AndesRobot-Oficial/Structure-Embedded-Systems/cad/README.md

# Modelo CAD

Archivo CAD del robot: modelo 3D completo de MILO, hecho en **Autodesk Fusion 360**.

| Archivo | Descripción |
|---|---|
| [`milo_ensamblaje.step`](milo_ensamblaje.step) | Ensamblaje completo en STEP (17 MB), exportado de Fusion 360 el 25-10-2026. Se abre en cualquier CAD |
| _por subir_ | Archivo nativo de Fusion (`.f3z`) |

## Cómo exportar desde Fusion 360

- **`.f3z`:** Archivo → Exportar → *Fusion Archive Files (.f3z)*. Incluye todas las piezas referenciadas del ensamblaje.
- **`.step`:** Archivo → Exportar → *STEP Files (.step)*.

Al actualizar el modelo, reemplaza los dos archivos y anota el cambio en el [CHANGELOG](../CHANGELOG.md).

> GitHub acepta archivos de hasta 100 MB.
