AndesRobot-Oficial/Structure-Embedded-Systems/electrica/README.md

# Eléctrica

Diagrama de conexiones de MILO.

| Contenido | Descripción |
|---|---|
| [`esquematicos/`](esquematicos/README.md) | Plano eléctrico (mapa de conexiones de ReWire) y árbol de potencia |
| [`cableado/`](cableado/README.md) | Lista de los 137 cables por circuito |
| [`presupuesto_potencia.csv`](presupuesto_potencia.csv) | Consumo de cada componente |
| [`revision_plano.md`](revision_plano.md) | Revisión del plano: puntos pendientes |
