AndesRobot-Oficial/Structure-Embedded-Systems/bom/README.md

# Lista de materiales (BOM)

Lista de componentes de MILO: todo lo que hay que comprar o fabricar.

## Componentes eléctricos

### Energía

| Componente | Modelo / N° de parte | Cant. | Notas |
|---|---|:-:|---|
| Batería Li-ion 10S2P 36 V · 4,4 Ah · 158 Wh | BMS 20 A continuos / 30 A pico | 2 | Carga a 42 V |
| Conversor DC-DC 42 V → 24 V, 20 A | UENPO (entrada 30–75 V) | 1 | |
| Conversor DC-DC 24 V → 12 V, 20 A | Kuongshun (entrada 6–40 V) | 1 | 15 A continuos |
| Conversor DC-DC 24 V → 6,6 V, 300 W | Kuongshun (entrada 7–32 V) | 1 | Hasta 8 A |

### Seguridad

| Componente | Modelo / N° de parte | Cant. | Notas |
|---|---|:-:|---|
| Seta de emergencia | 2 contactos NC | 1 | |

### Tracción

| Componente | Modelo / N° de parte | Cant. | Notas |
|---|---|:-:|---|
| Placa controladora de hoverboard | STM32, firmware FOC (EFeru) | 1 | |
| Pulsador de encendido | Original de la placa | 1 | |
| Rueda con motor BLDC en buje 6,5" | 36 V · ~350 W | 2 | |

### Control

| Componente | Modelo / N° de parte | Cant. | Notas |
|---|---|:-:|---|
| Computador principal | NVIDIA Jetson Orin Nano Dev Kit | 1 | Entrada 9–20 V |
| Microcontrolador | Arduino Mega 2560 | 1 | |
| Adaptador USB a TTL | CH340G | 1 | Puente 5 V / 3,3 V |
| Hub USB 3.0 alimentado, 7 puertos | Entrada 12 V | 1 | |

### Sensores

| Componente | Modelo / N° de parte | Cant. | Notas |
|---|---|:-:|---|
| Cámara de profundidad | Orbbec Gemini Plus | 1 | |
| LiDAR | Slamtec RPLIDAR C1 | 1 | |
| IMU 9 ejes USB | Handsfree HFI-B9 | 1 | |
| IMU 9 ejes I2C | MPU-9250 (módulo GY-9250) | 1 | |
| Cámara de visión IA | Hiwonder WonderMV (K210) | 1 | |

### Pantallas

| Componente | Modelo / N° de parte | Cant. | Notas |
|---|---|:-:|---|
| Monitor 11,6" | MUCAI N116A | 1 | Modelo no definitivo |
| Pantalla táctil 5" | Victron GX Touch 50 | 1 | Modelo no definitivo |
| Hub DisplayPort MST (1× DP → 2× HDMI) | _por elegir_ | 1 | |

### Actuadores

| Componente | Modelo / N° de parte | Cant. | Notas |
|---|---|:-:|---|
| Driver paso a paso (9–42 V · 0,5–4,0 A) | TB6600 | 7 | |
| Motor NEMA 23, 1,26 N·m · 2,8 A/fase | StepperOnline 23HS22-2804S1 | 3 | |
| Motor NEMA 23, 2,9 N·m · 3,0 A/fase | 57HS112-3004 | 1 | |
| Motor NEMA 17, ~0,45 N·m · ~1,5 A/fase | _por confirmar_ | 3 | Confirmar corriente en la etiqueta |
| Servo digital 20 kg·cm a 6,6 V | Power HD LF-20MG | 1 | |

## Perfilería

| Componente | Medida | Cant. | Notas |
|---|---|:-:|---|
| | | | |

## Tornillería

| Componente | Medida | Cant. | Notas |
|---|---|:-:|---|
| | | | |
