AndesRobot-Oficial/Structure-Embedded-Systems/electrica/presupuesto_potencia.csv

componente | cantidad | riel | voltaje_v | potencia_tipica_w_c_u | potencia_max_w_c_u | fuente_dato | notas
Placa hoverboard + ruedas BLDC 6.5" | 1 | 36 V batería | 36 | 50 | 612 | estimado | Típica = avance en piso plano interior (estimado). Máx = límite de corriente del firmware FOC por defecto (~17 A DC); confirmar con la configuración real
Jetson Orin Nano Dev Kit | 1 | 12 V | 12 | 15 | 25 | datasheet NVIDIA (modos 7-25 W) | Depende del modo de potencia (nvpmodel)
Hub USB 3.0 alimentado (propio) | 1 | 12 V | 12 | 1 | 2 | estimado | Sin contar lo que entrega por los puertos
Monitor MUCAI N116A | 1 | 5 V USB (hub) | 5 |  |  | confirmar | Ver si el puerto del hub alcanza a entregarle la corriente
Victron GX Touch 50 | 1 | 5 V USB (hub) | 5 |  |  | confirmar
Hub DisplayPort MST | 1 | 5 V USB (hub) | 5 |  |  | confirmar | Modelo por elegir
Orbbec Gemini Plus | 1 | 5 V USB (Jetson) | 5 |  |  | confirmar
RPLIDAR C1 | 1 | 5 V USB (hub) | 5 |  |  | confirmar
IMU HFI-B9 | 1 | 5 V USB (hub) | 5 |  |  | confirmar
Hiwonder WonderMV | 1 | 5 V USB (hub) | 5 | 1.5 | 1.5 | plano (5 V ~300 mA)
USB a TTL CH340G | 1 | 5 V USB (hub) | 5 | 0.1 | 0.1 | estimado
Arduino Mega 2560 + MPU-9250 | 1 | 5 V USB (Jetson) | 5 | 0.5 | 1 | estimado
TB6600 + NEMA 23 23HS22-2804S1 (1.26 N·m) | 3 | 24 V | 24 | 14 | 14 | estimado (2 fases × 2.8 A² × 0.89 Ω) | Pérdida en el motor con corriente nominal; se reduce si el driver baja la corriente en reposo
TB6600 + NEMA 23 57HS112-3004 (2.9 N·m) | 1 | 24 V | 24 | 23 | 23 | estimado (2 fases × 3.0 A² × 1.3 Ω) | Ídem
TB6600 + NEMA 17 | 3 | 24 V | 24 | 9 | 9 | estimado (~1.5 A/fase; confirmar etiqueta) | Ídem
Servo Power HD LF-20MG | 1 | 6.6 V | 6.6 |  |  | confirmar | Usar corriente de bloqueo del datasheet como máx
