AndesRobot-Oficial/Structure-Embedded-Systems/cad/milo_ensamblaje.step

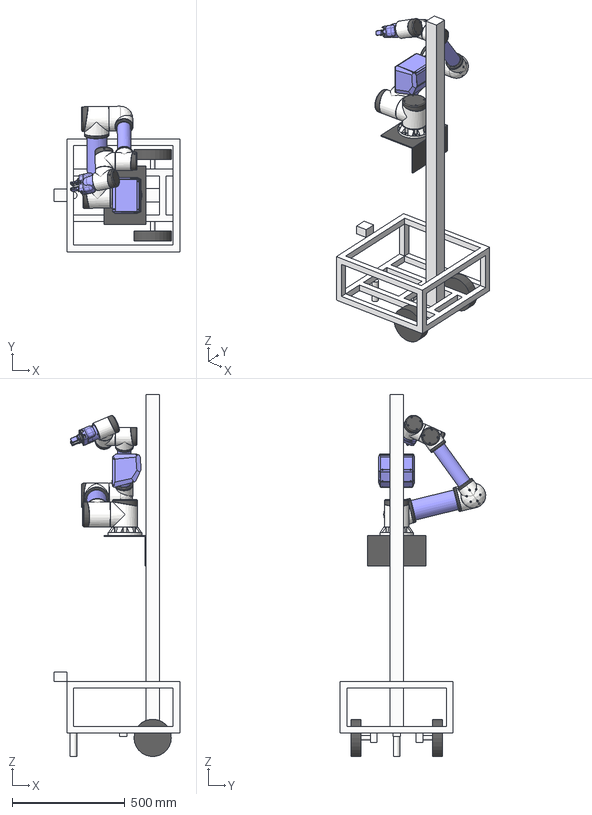
[picture p1: CAD file, 2026-10-26]
cad/milo_ensamblaje.step
555.8 x 644.6 x 1603.0 mm
old_component (1)
old_component (2)
old_component (3)
old_component (4)
old_component (6)
old_component (7)
old_component (8)
old_component (9)
old_component (10)
old_component (11)
old_component (12)
old_component
old_component (13)
old_component (14)
old_component (15)
old_component (16)
old_component (17)
Venus_Touch - display-screen_MODEL_1
Victron_CCGX2_Screen
RealSense_D435
