AndesRobot-Oficial/Structure-Embedded-Systems/milo_description/meshes/link_1_1.stl

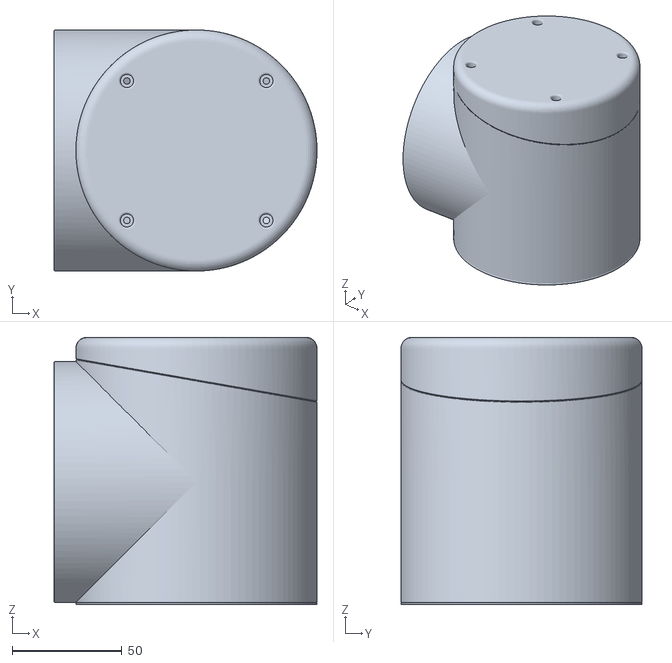
[picture p2: CAD file, 2026-10-26]
milo_description/meshes/link_1_1.stl
120.0 x 110.0 x 122.0
