AndesRobot-Oficial/Structure-Embedded-Systems/milo_description/meshes/link_6_1.stl

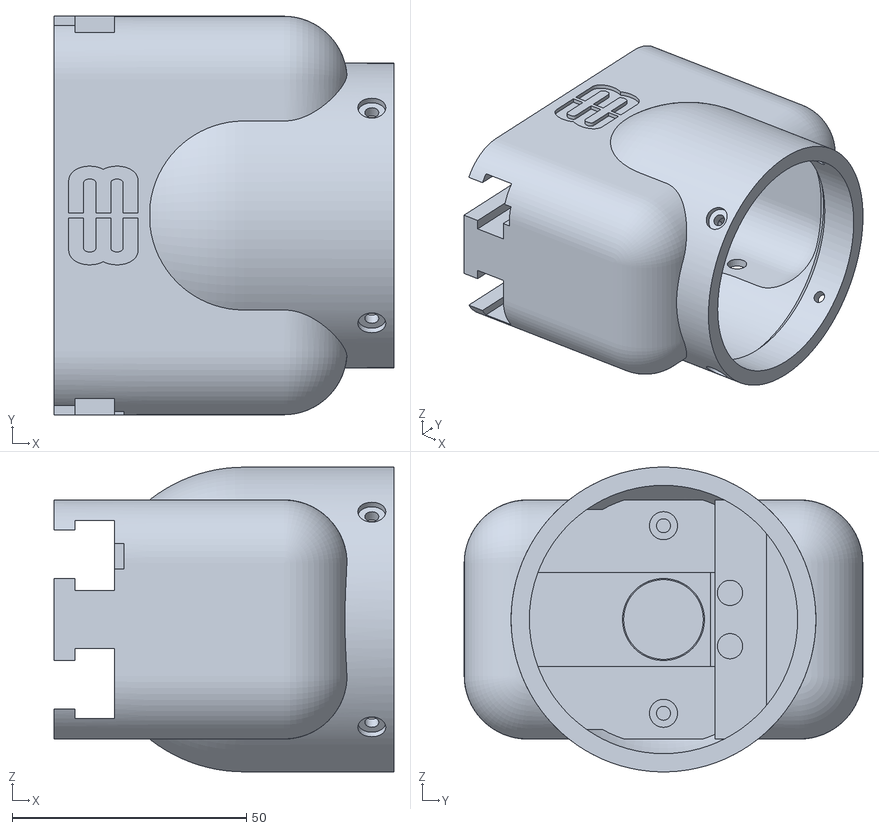
[picture p3: CAD file, 2026-10-26]
milo_description/meshes/link_6_1.stl
72.5 x 85.0 x 65.0
