AndesRobot-Oficial/Structure-Embedded-Systems/milo_description/meshes/link_3_1.stl

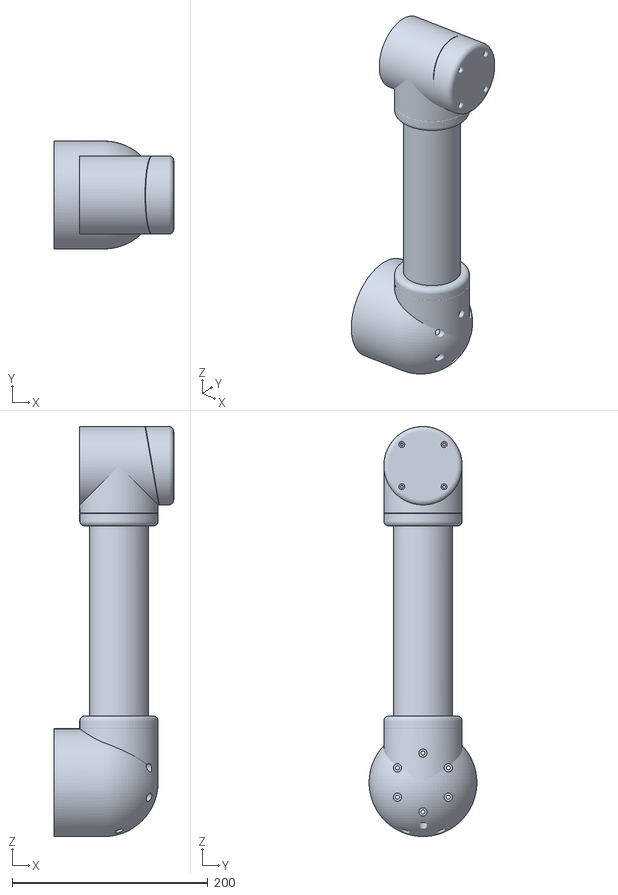
[picture p4: CAD file, 2026-10-26]
milo_description/meshes/link_3_1.stl
122.0 x 110.0 x 418.5
