AndesRobot-Oficial/Structure-Embedded-Systems/milo_description/meshes/imu_link_1.stl

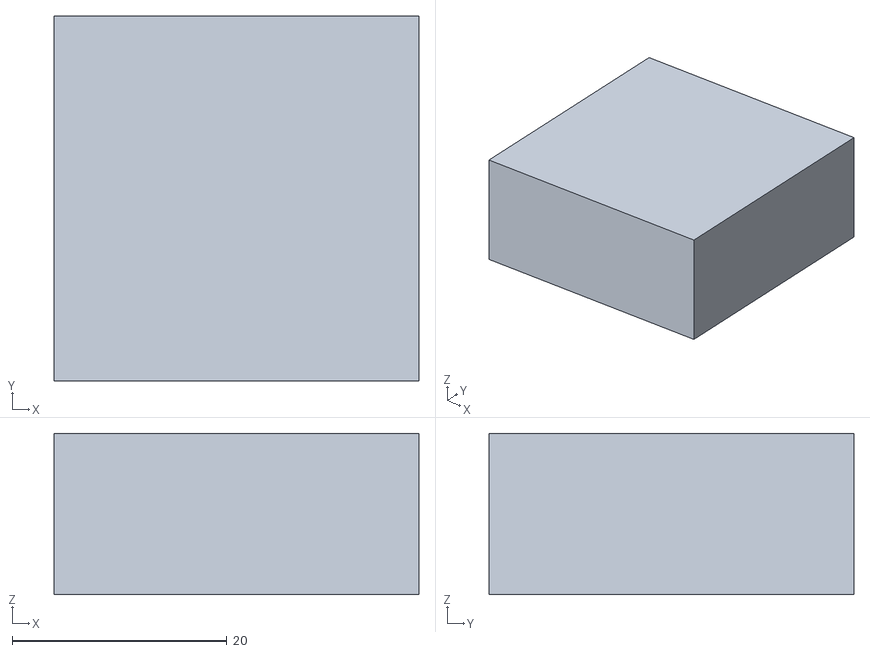
[picture p5: CAD file, 2026-10-26]
milo_description/meshes/imu_link_1.stl
34.0 x 34.0 x 15.0
