AndesRobot-Oficial/Structure-Embedded-Systems/milo_description/meshes/right_wheel_link_1.stl

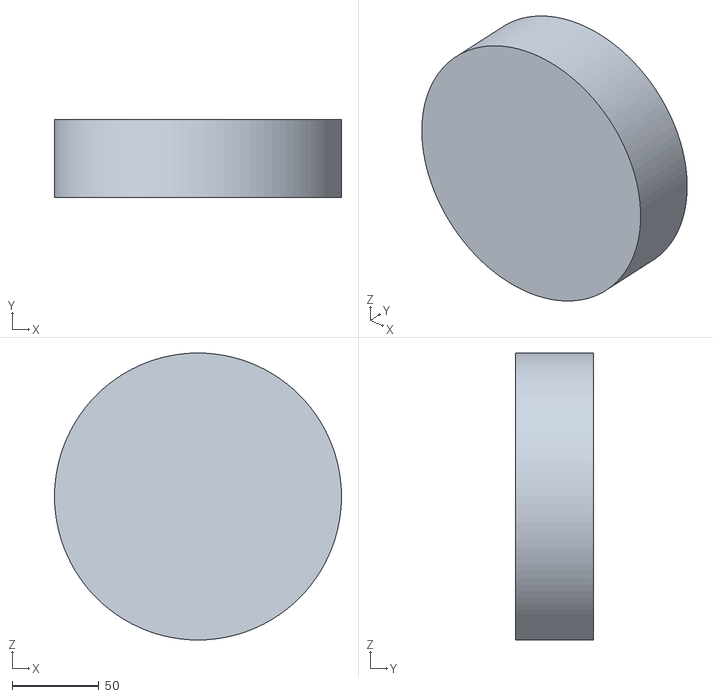
[picture p6: CAD file, 2026-10-26]
milo_description/meshes/right_wheel_link_1.stl
165.1 x 45.0 x 165.1
