AndesRobot-Oficial/Structure-Embedded-Systems/milo_description/meshes/vertical_column_link_1.stl

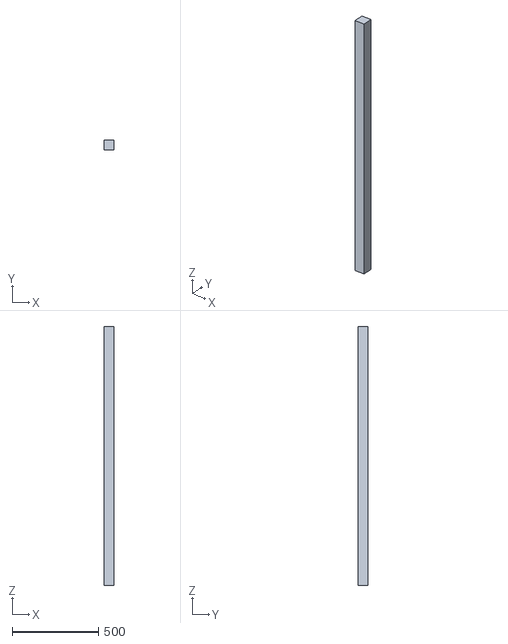
[picture p7: CAD file, 2026-10-26]
milo_description/meshes/vertical_column_link_1.stl
60.0 x 60.0 x 1500.0
