AndesRobot-Oficial/Structure-Embedded-Systems/milo_description/meshes/left_finger_link_1.stl

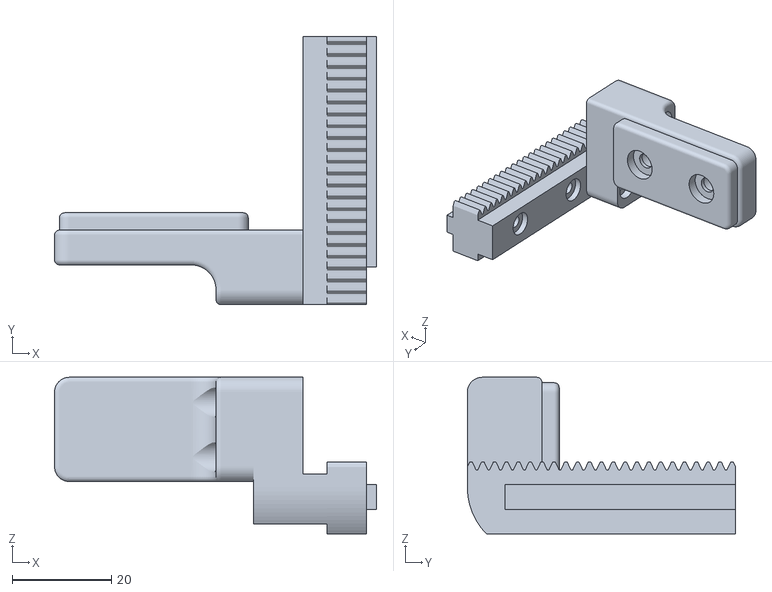
[picture p8: CAD file, 2026-10-26]
milo_description/meshes/left_finger_link_1.stl
64.8 x 54.0 x 31.5
