AndesRobot-Oficial/Structure-Embedded-Systems/milo_description/meshes/link_2_1.stl

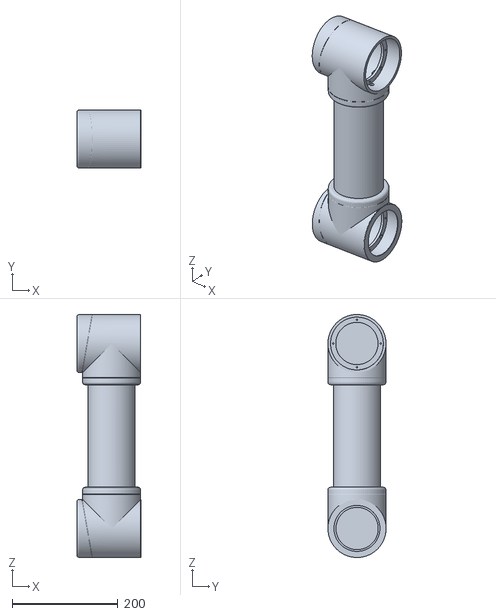
[picture p9: CAD file, 2026-10-26]
milo_description/meshes/link_2_1.stl
122.1 x 110.2 x 460.2
