AndesRobot-Oficial/Structure-Embedded-Systems/milo_description/meshes/link_4_1.stl

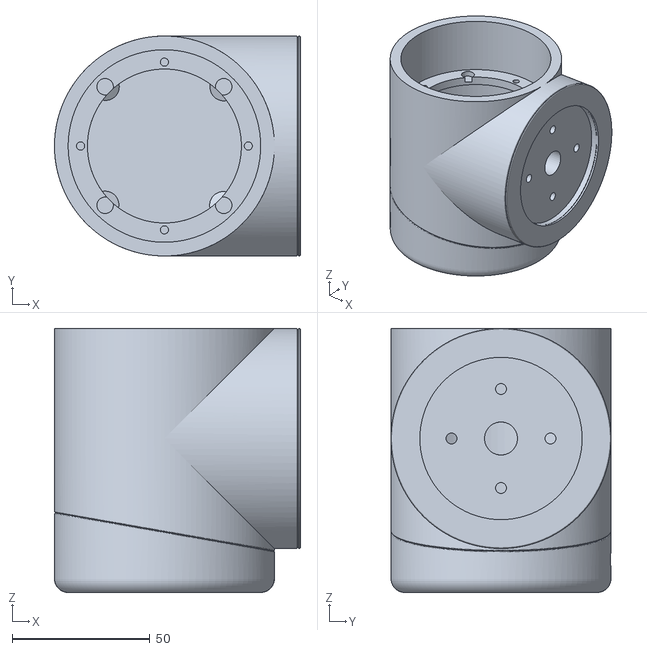
[picture p10: CAD file, 2026-10-26]
milo_description/meshes/link_4_1.stl
89.5 x 80.0 x 96.0
