AndesRobot-Oficial/Structure-Embedded-Systems/milo_description/meshes/lidar_link_1.stl

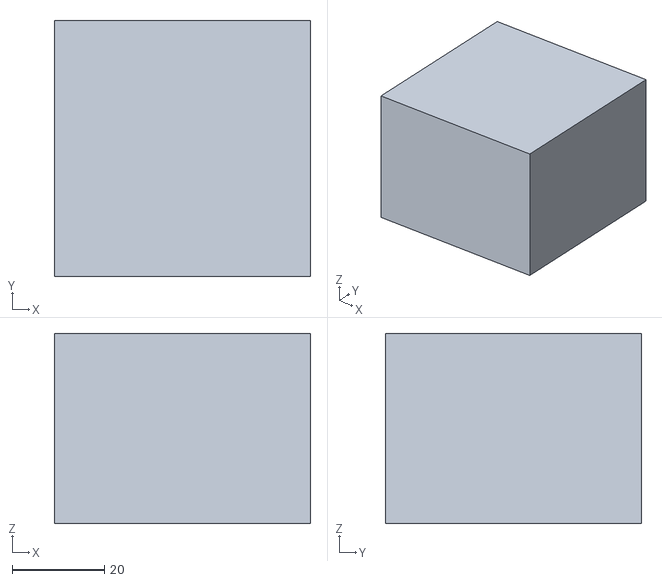
[picture p11: CAD file, 2026-10-26]
milo_description/meshes/lidar_link_1.stl
55.6 x 55.6 x 41.3
