AndesRobot-Oficial/Structure-Embedded-Systems/milo_description/meshes/arm_base_link_1.stl

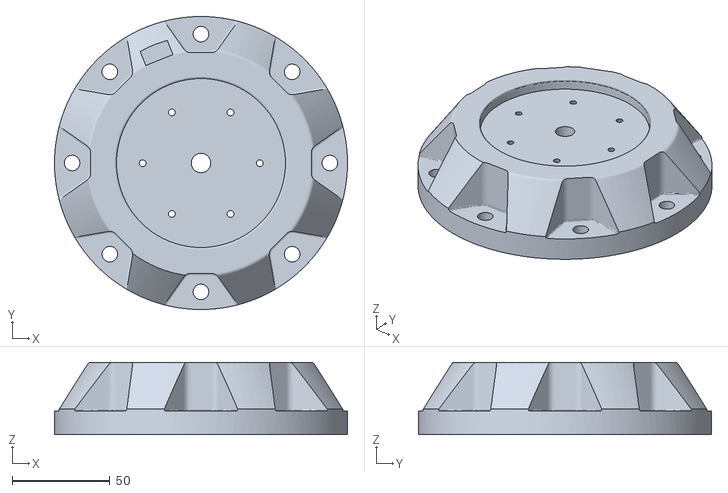
[picture p12: CAD file, 2026-10-26]
milo_description/meshes/arm_base_link_1.stl
150.0 x 150.0 x 37.0
