AndesRobot-Oficial/Structure-Embedded-Systems/milo_description/meshes/link_5_1.stl

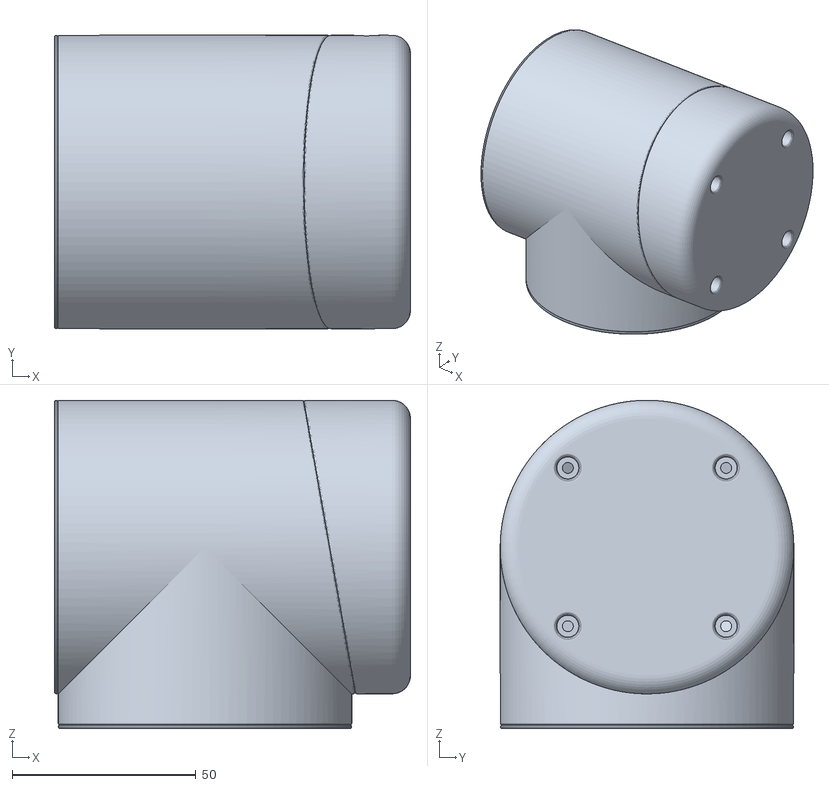
[picture p13: CAD file, 2026-10-26]
milo_description/meshes/link_5_1.stl
97.0 x 80.0 x 89.5
