AndesRobot-Oficial/Structure-Embedded-Systems/milo_description/meshes/base_link.stl

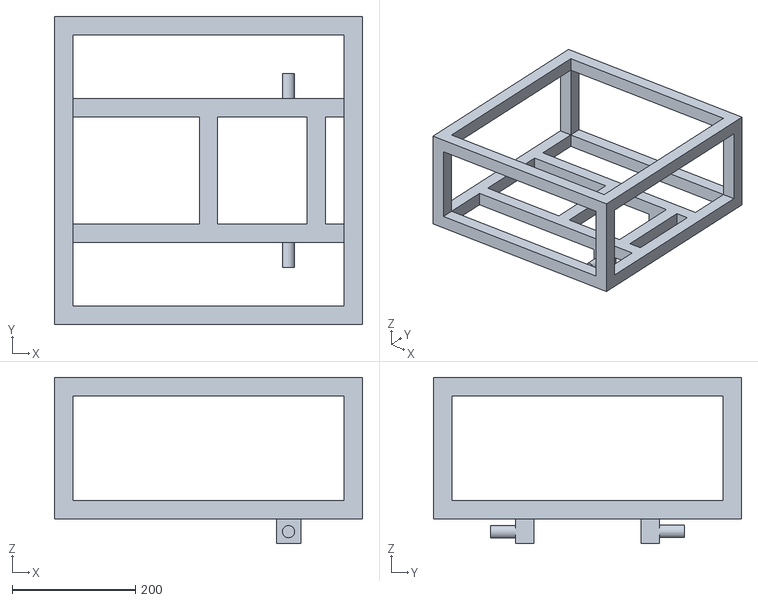
[picture p14: CAD file, 2026-10-26]
milo_description/meshes/base_link.stl
500.0 x 500.0 x 270.0
