AndesRobot-Oficial/Structure-Embedded-Systems/milo_description/meshes/lift_carriage_link_1.stl

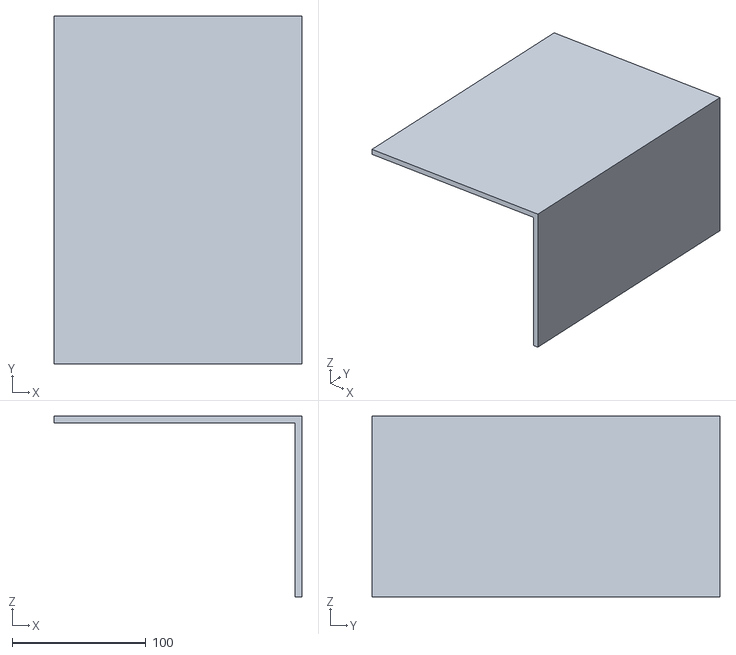
[picture p15: CAD file, 2026-10-26]
milo_description/meshes/lift_carriage_link_1.stl
185.0 x 260.0 x 135.0
