AndesRobot-Oficial/Structure-Embedded-Systems/(list of files, cad)

Other CAD files:
milo_description/meshes/left_wheel_link_1.stl
milo_description/meshes/right_finger_link_1.stl
