AndesRobot-Oficial/Structure-Embedded-Systems/CHANGELOG.md

# Changelog

Formato basado en [Keep a Changelog](https://keepachangelog.com/es-ES/1.1.0/).

## [Sin publicar]
### Agregado
- Estructura inicial del repositorio, plantillas de BOM, cableado y presupuesto de potencia.
- `milo_description`: paquete `andesrobot_description` del CAD de Fusion 360, con masas estimadas (rev. 0).
- Plano eléctrico rev. 1.0, tabla de cableado generada, presupuesto de potencia y revisión del plano.
