AndesRobot-Oficial/Structure-Embedded-Systems/(commit log)

2026-10-25 Estructura inicial del repositorio de la base de MILO
    Carpetas de mecánica, eléctrica y docs con plantillas (BOM, cableado,
    presupuesto de potencia, checklist), interfaz con el equipo del brazo,
    configuración de Git LFS y paquete ROS 2 milo_description con URDF provisorio.
    Claude-Session: https://claude.ai/code/session_01BTW9ot9YC3wLhXhE3iwN4N
    [bom.csv, inertias.xacro, milo.urdf.xacro, presupuesto_potencia.csv, tabla_cableado.csv]
2026-10-25 Agregar plano eléctrico rev. 1.0 y su documentación
    - Plano de Mesa de Cableado (37 componentes, 137 cables)
    - Tabla de cableado generada desde el plano + script para regenerarla
    - Presupuesto de potencia con autonomía estimada
    - Árbol de potencia y señales de control en el README de esquemáticos
    - Revisión del plano con 17 puntos pendientes
    - Radio de rueda real (6.5") en el URDF
    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
    [milo.urdf.xacro, presupuesto_potencia.csv, tabla_cableado.csv]
2026-10-26 Update README to remove arm development note
    Removed note about the arm being developed by another team.
2026-10-26 Completar README, BOM eléctrico y quitar Git LFS
    - README: medidas, velocidad, carga del brazo, pantallas, software y CAD;
    estado actualizado, sección del brazo pendiente y contacto.
    - BOM: componentes eléctricos del plano; perfilería y tornillería por completar.
    - .gitattributes: sin reglas de Git LFS.
    - mecanica/cad: Fusion 360.
    [bom.csv]
2026-10-26 README: quitar referencias al brazo y la sección de contribución
2026-10-26 Quitar la interfaz con el brazo; dejar solo el arm_mount_link
    - Se elimina interfaz_brazo/.
    - URDF y milo_description/README: arm_mount_link solo como punto de montaje.
    - CHANGELOG, cálculos y checklist sin referencias al brazo.
    [milo.urdf.xacro]
2026-10-26 BOM en texto y lista de cableado profesional
    - bom/README.md: BOM como tablas por subsistema (reemplaza bom.csv);
    perfilería y tornillería por completar.
    - electrica/cableado/README.md: los 137 cables del mapa de ReWire,
    agrupados por circuito, con resumen por calibre y código de colores.
    [bom.csv]
2026-10-26 Estimación de masas rev. 0
    Masas por parte a partir del CAD (volúmenes), perfiles V-slot 3030/6060,
    PVC sanitario, PLA al 40 % y motores por articulación. Total ~31 kg.
2026-10-26 Masas: centro de masa y límites de vuelco
    Baterías abajo y drivers sobre la base hacia atrás. Seis casos de brazo
    y elevador, con la aceleración de vuelco hacia atrás, adelante y lateral.
2026-10-26 milo_description: URDF del CAD con masas estimadas
    - Reemplaza la plantilla provisoria por el paquete andesrobot_description
    de milo_ws (URDF/xacro, mallas, launch y RViz).
    - Masas de docs/calculos/masas.md; inercias escaladas en la misma proporción.
    - Lastre de 12 kg reemplazado por baterías (2,2 kg, abajo) y drivers
    (1,3 kg, sobre la base hacia atrás).
    [andesrobot.gazebo.xacro, andesrobot.materials.xacro, andesrobot.ros2_control.xacro, andesrobot.sim.xacro, andesrobot.urdf.xacro, arm_base_link_1.stl, base_link.stl, imu_link_1.stl]
2026-10-26 Quitar carpetas que no se usan
    Se eliminan mecanica/ (cad, dxf, planos, step, stl), electrica/pcb,
    electrica/herramientas, docs/ensamblaje, docs/datasheets y docs/fotos.
    README y referencias actualizados.
2026-10-26 Agregar apartado cad/ para el modelo 3D
2026-10-26 cad: subir el ensamblaje completo en STEP
    milo_ensamblaje.step (17 MB), exportado de Fusion 360. Los archivos CAD
    se marcan como binarios en .gitattributes.
    [milo_ensamblaje.step]
2026-10-26 Eliminar docs/calculos
    Se quita la carpeta de cálculos (masas, centro de masa y vuelco) y las
    referencias a ella en el README y en milo_description.
    [andesrobot.urdf.xacro]
2026-10-26 Lista de componentes
2026-10-26 Archivo CAD del robot
2026-10-26 Diagrama de conexiones
2026-10-26 URDF del robot con masas calculadas
